Ryafar/ESP32-SoilSensor_KiCad-PCB/docs/hardware/3D/TOP_3D_rev0.1.0.png

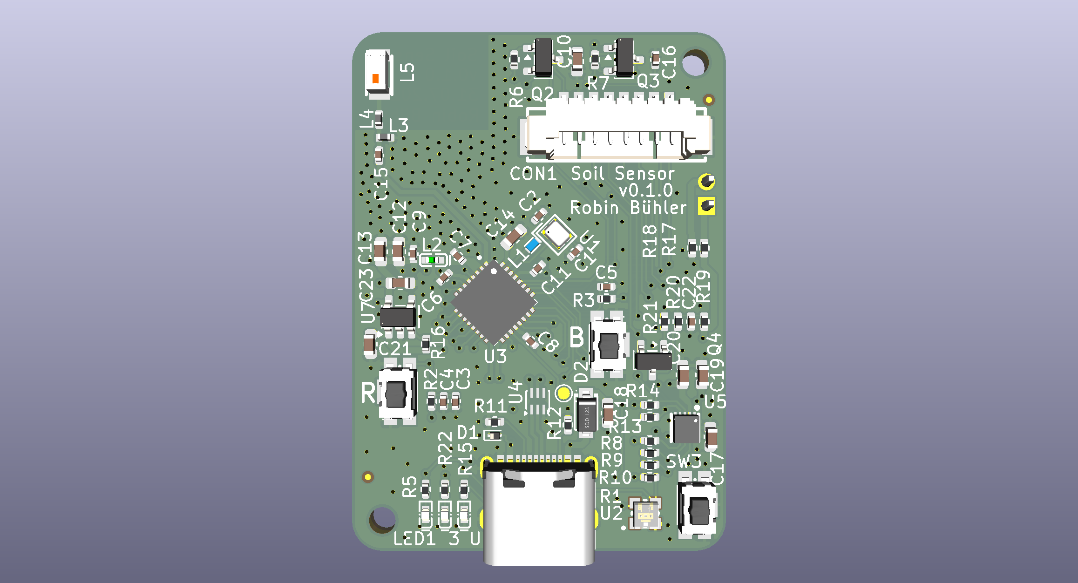
docs/hardware/3D/TOP_3D_rev0.1.0.png
