Ryafar/ESP32-SoilSensor_KiCad-PCB/docs/hardware/3D/soil-sensor_pcb_dimensions_rev0.1.0.pdf

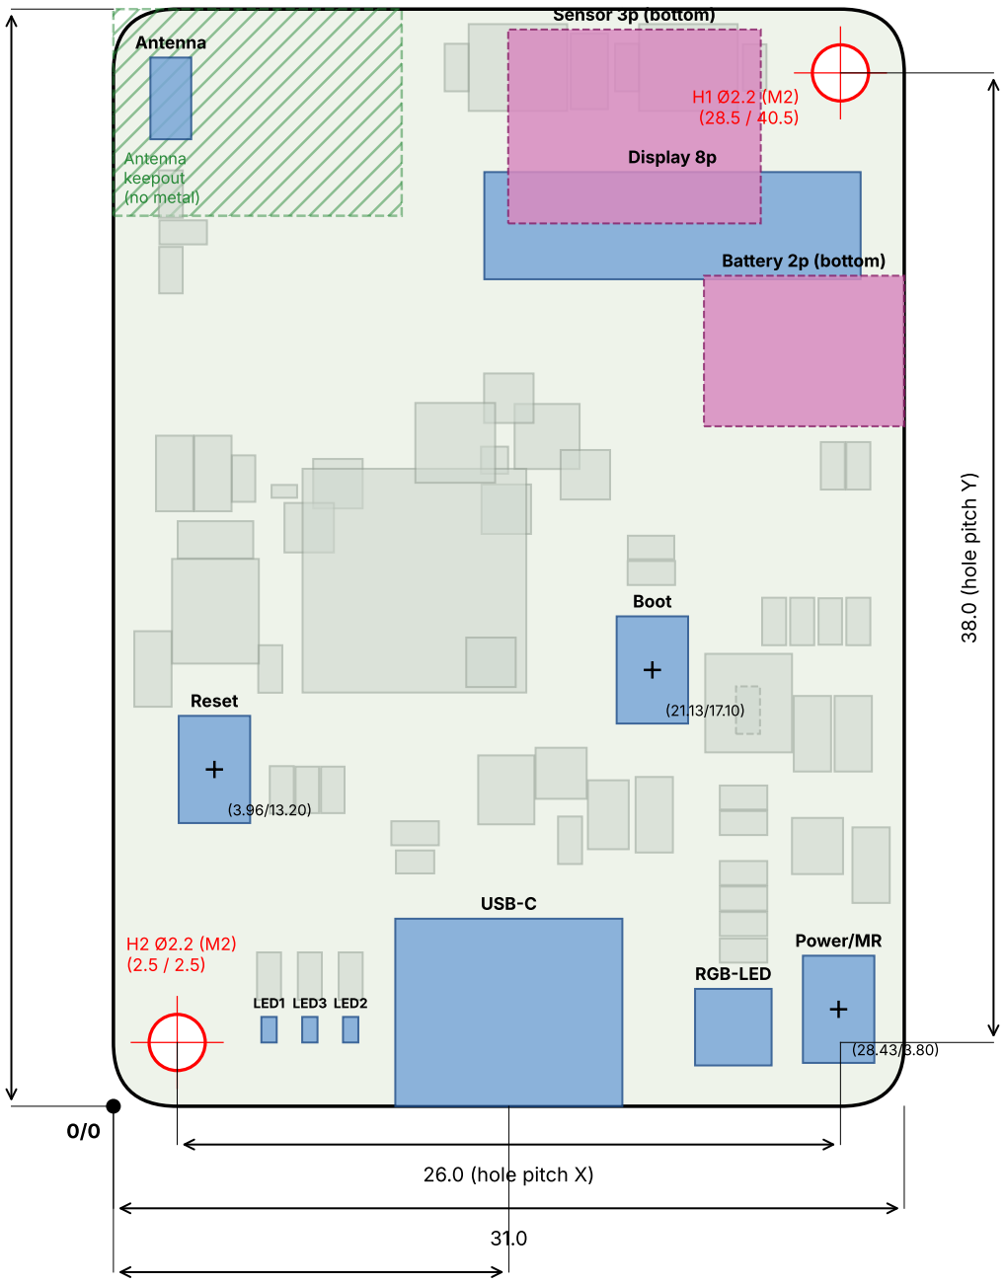
[picture p3: figure]
Antenna keepout (no metal); LED3; USB-C; Power/MR; Boot; Display 8p; Reset; LED1; LED2; Antenna; RGB-LED; Sensor 3p (bottom); Battery 2p (bottom); 26.0 (hole pitch X); 38.0 (hole pitch Y)

43.0

## 15.5 (USB center)

### R2.5 all corners · thickness 1.6 mm · dimensions in mm · top view blue = top side, pink dashed = bottom side

## Soil Sensor v0.1.0 – PCB Dimension Drawing
