Ryafar/ESP32-SoilSensor_KiCad-PCB/docs/hardware/3D/BOT_3D.png

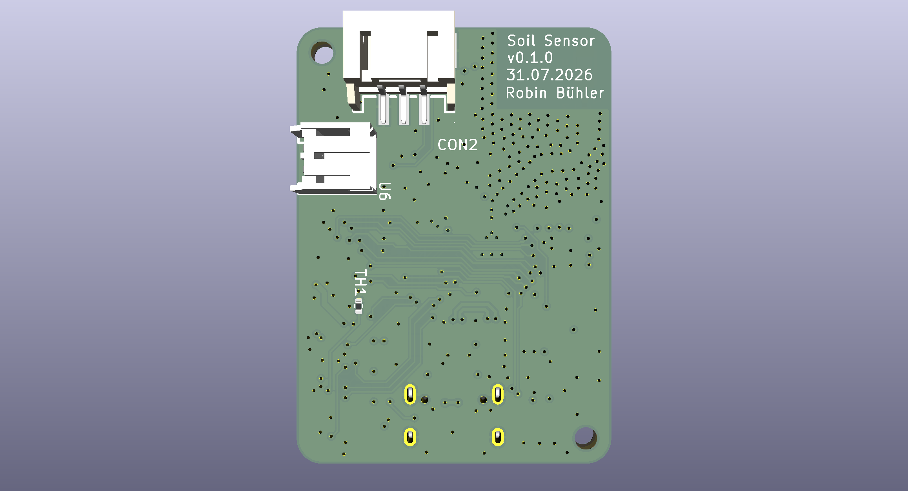
docs/hardware/3D/BOT_3D.png
