Ryafar/ESP32-SoilSensor_KiCad-PCB/docs/hardware/3D/soil-sensor_pcb_outline_rev0.1.0.dxf

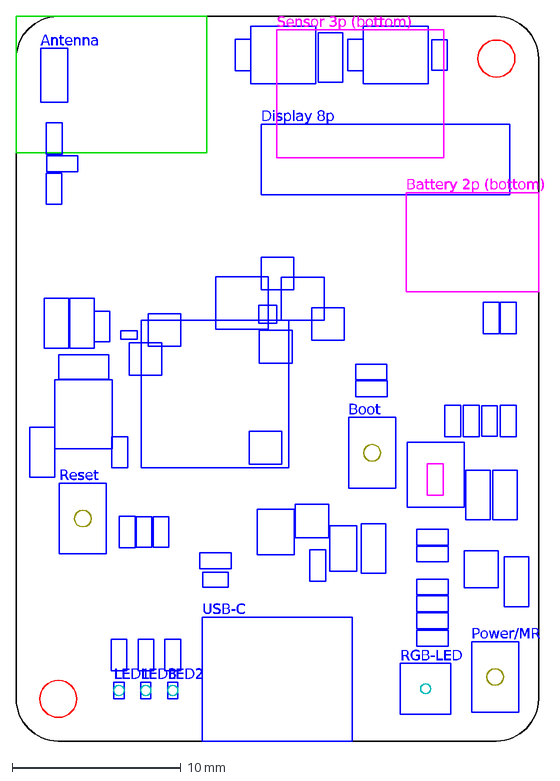
[picture p5: CAD file, 2026-10-10]
docs/hardware/3D/soil-sensor_pcb_outline_rev0.1.0.dxf
LED3
USB-C
Power/MR
Boot
Display 8p
Reset
LED1
LED2
Antenna
RGB-LED
Sensor 3p (bottom)
Battery 2p (bottom)
