Ryafar/ESP32-SoilSensor_KiCad-PCB/docs/hardware/Schematic_v0.1.0.pdf

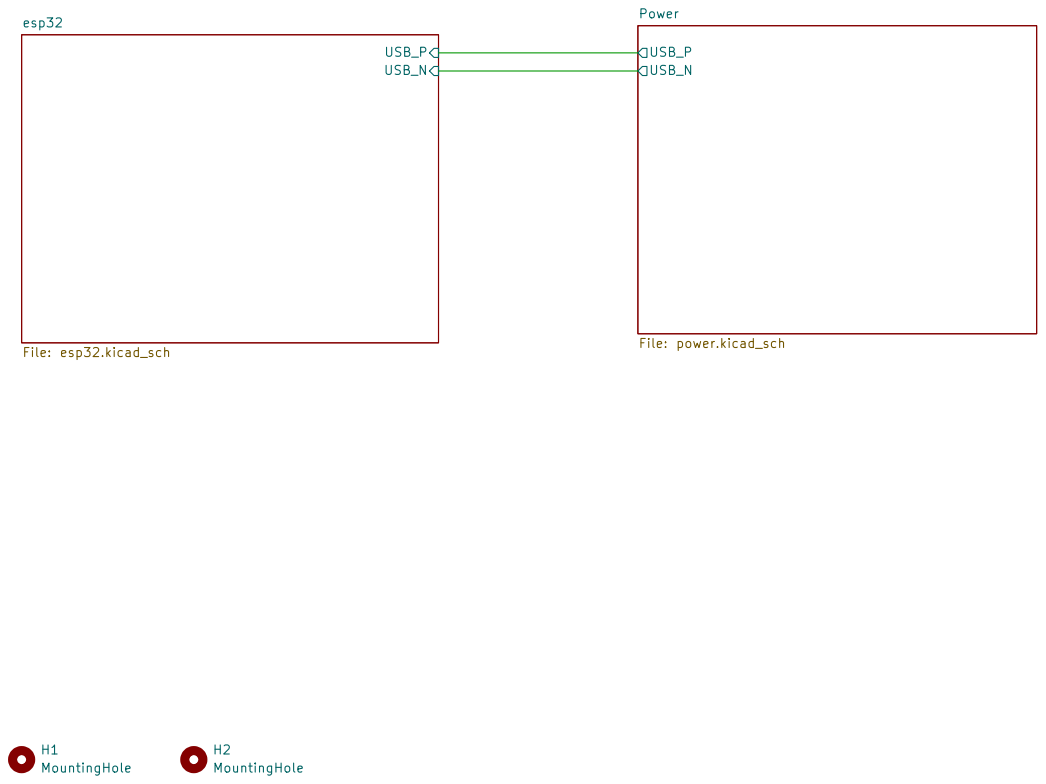
[picture p6: page 1]

Size: A3 | Rev: 0.1.0 | F Date: 2026-06-26
KiCad E.D.A. 10.0.1 | Id: 1/3

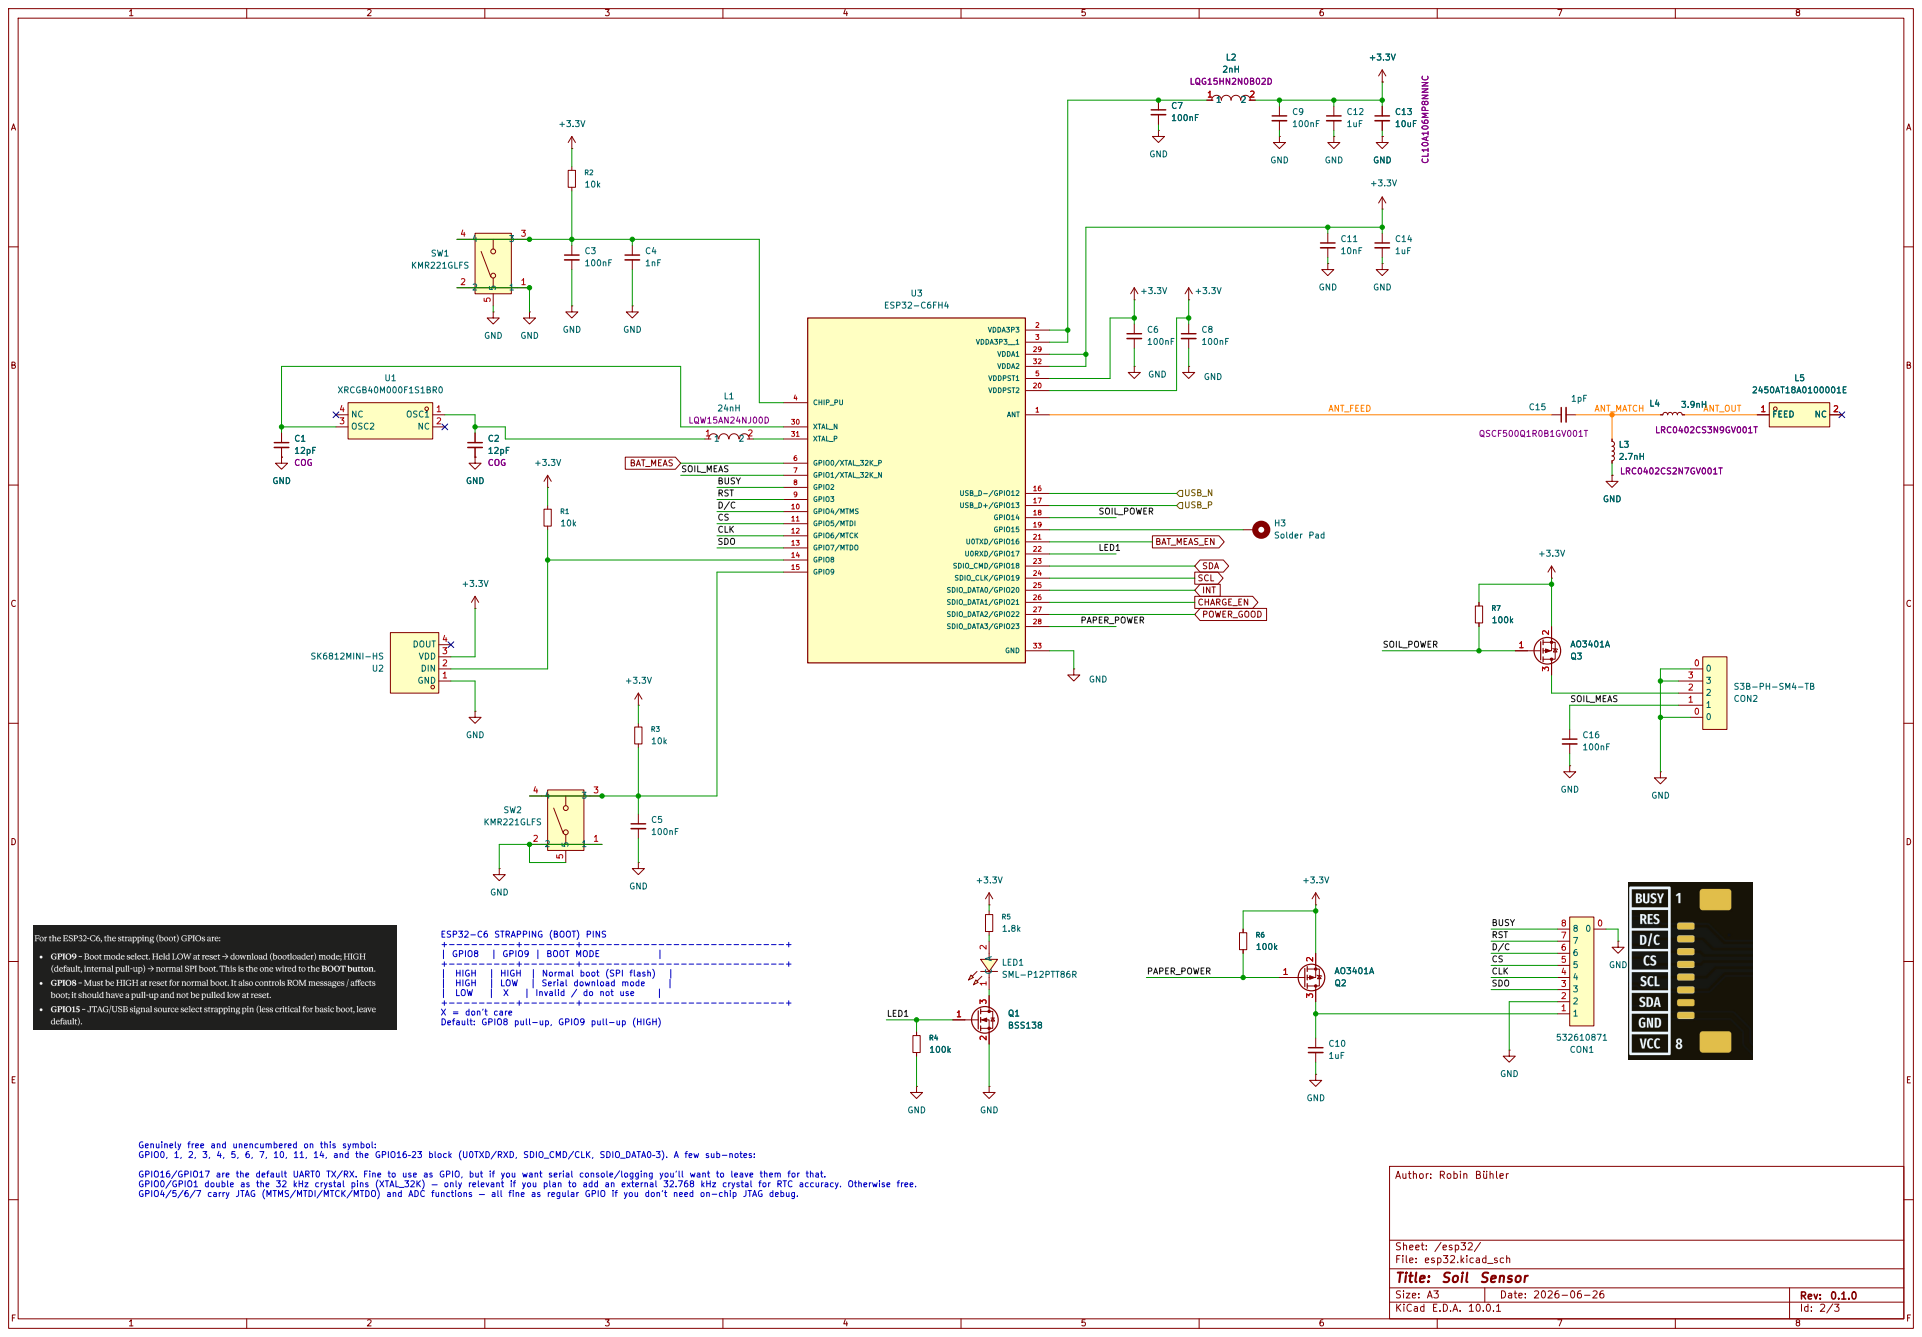
[picture p7: page 2]

LED1 Genuinely free and unencumbered on this symbol:

GPIO0, 1, 2, 3, 4, 5, 6, 7, 10, 11, 14, and the GPIO16–23 block (U0TXD/RXD, SDIO_CMD/CLK, SDIO_DATA0–3). A few sub-notes: GPIO16/GPIO17 are the default UART0 TX/RX. Fine to use as GPIO, but if you want serial console/logging you'll want to leave them for that. GPIO0/GPIO1 double as the 32 kHz crystal pins (XTAL_32K) — only relevant if you plan to add an external 32.768 kHz crystal for RTC accuracy. Otherwise free. GPIO4/5/6/7 carry JTAG (MTMS/MTDI/MTCK/MTDO) and ADC functions — all fine as regular GPIO if you don't need on-chip JTAG debug. ESP32-C6 STRAPPING (BOOT) PINS +---------+-------+---------------------------+

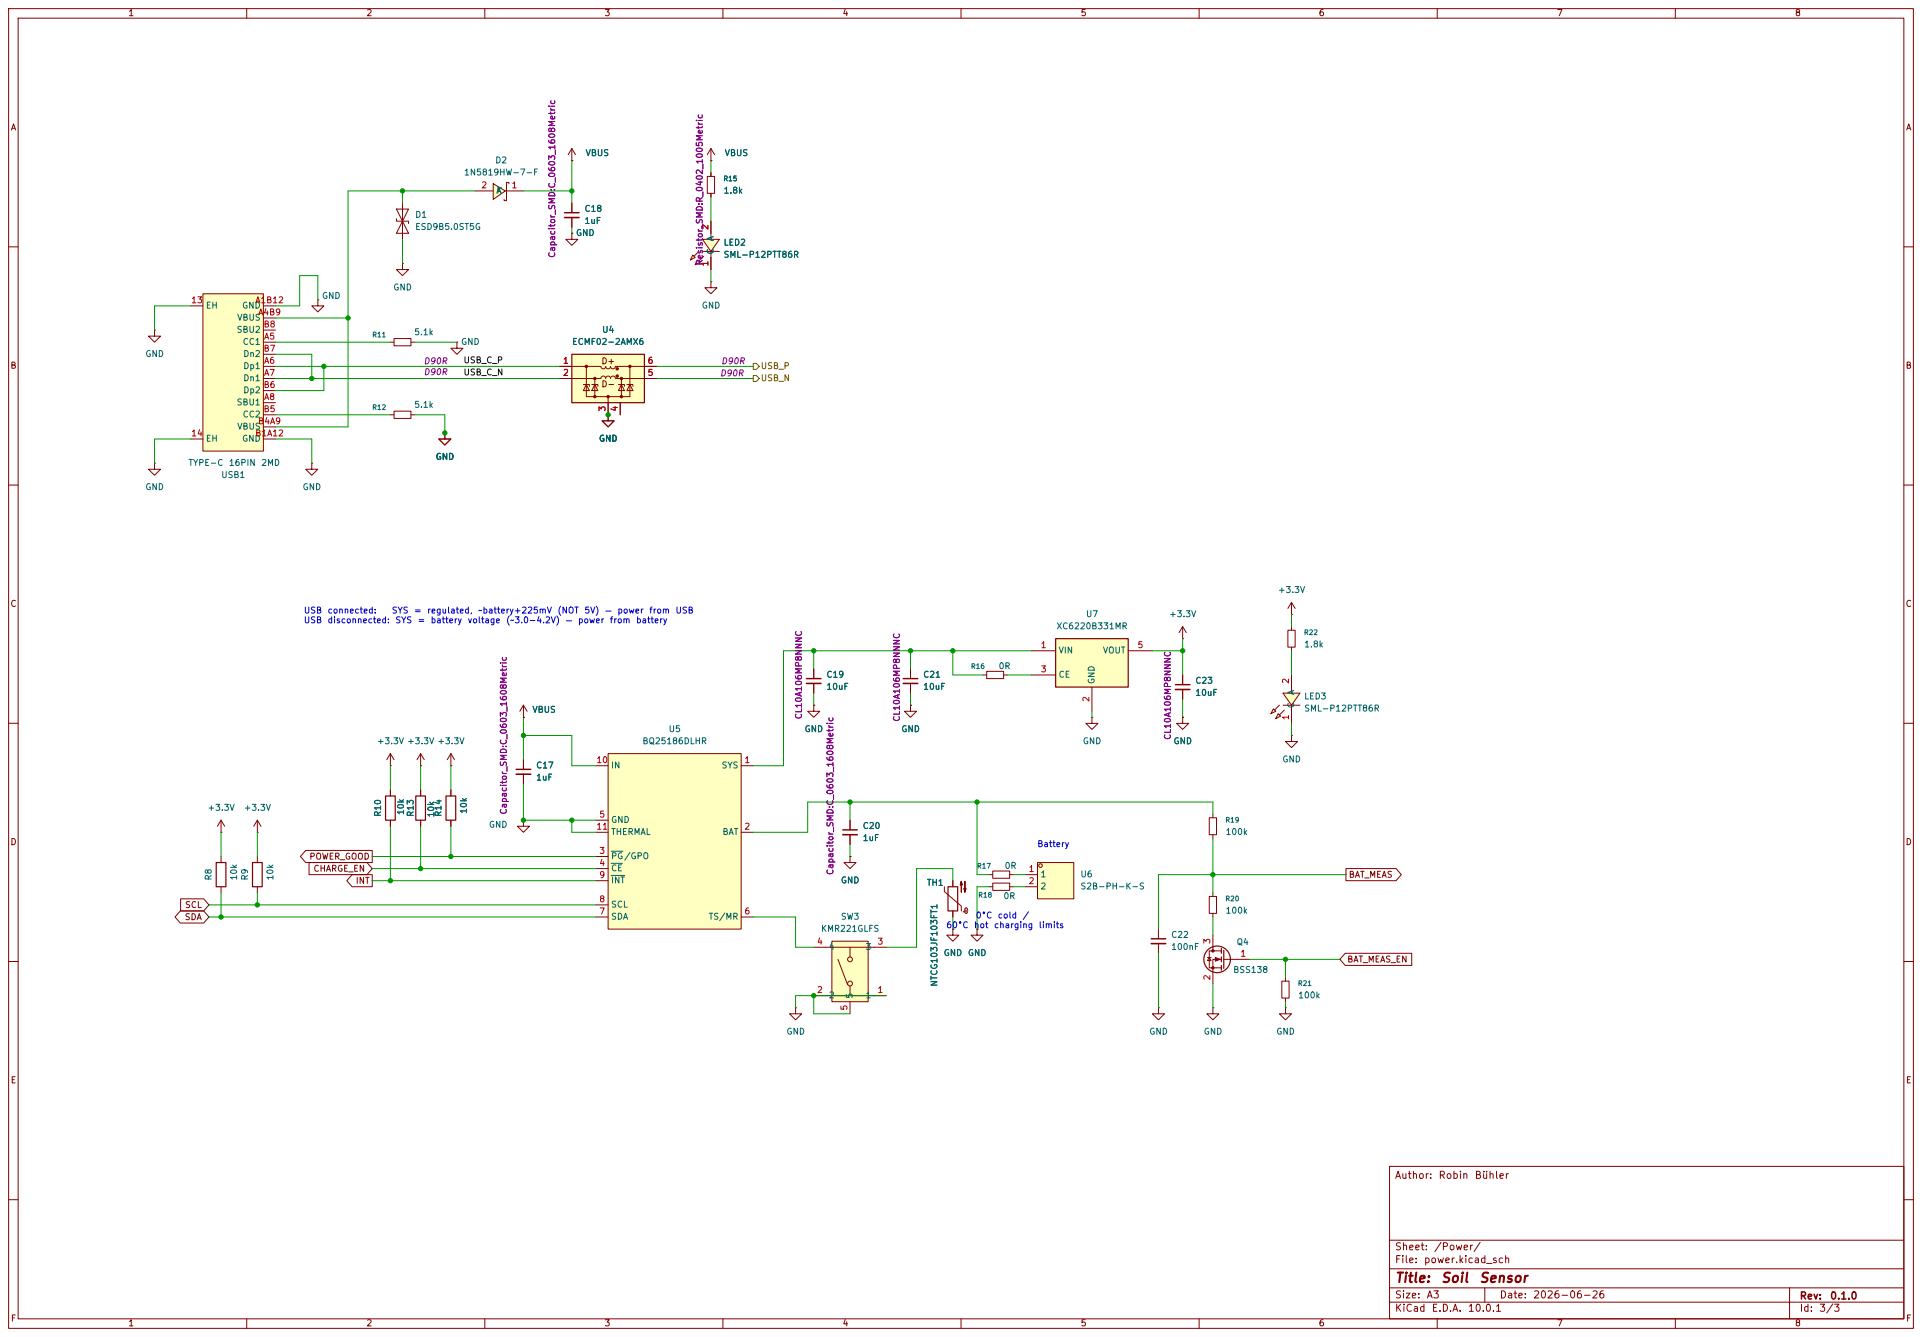
[picture p8: page 3]
