Ryafar/ESP32-SoilSensor_KiCad-PCB/main/config.h

/* Board configuration for the Soil Sensor, KiCad project rev 0.1.0.
 *
 * Single source of truth for pin assignment and system-wide constants.
 * Taken from docs/hardware/hardware-info.md - keep both in sync when the
 * board changes. Drivers under components/ stay board-agnostic and receive
 * these values through their init structs.
 *
 * What is NOT here: the switches that decide how the firmware behaves rather
 * than what the board is. They sit in one block at the top of
 * main/app/app_run.c - deep sleep on or off, ship mode armed, the radio, and
 * the bench overrides that fake a flat cell. This file answers "what is
 * wired where and at which voltage"; that block answers "what does the
 * firmware do with it".
 */
#pragma once

/* --- E-ink display, SPI (CON1) ------------------------------------------ */
#define PIN_EPD_BUSY        2   // input
#define PIN_EPD_RST         3   // output
#define PIN_EPD_DC          4   // output
#define PIN_EPD_CS          5   // output
#define PIN_EPD_CLK         6   // SPI SCLK
#define PIN_EPD_MOSI        7   // SPI MOSI, display is write-only
#define PIN_EPD_POWER      23   // load switch for the display rail (AO3401A)

/* Which of the two panels is fitted is a build-time choice and lives in
 * components/eink/include/eink_panel.h - it decides which controller driver is
 * compiled, so it cannot come from here. */

/* SPI2 is the only general-purpose SPI host on the C6, and the display is the
 * only device on it. Expanded at the point of use, so config.h stays free of
 * ESP-IDF headers. */
#define EPD_SPI_HOST        SPI2_HOST

/* AO3401A is a P-FET high-side switch: the gate goes to GND to conduct.
 * Confirmed against the schematic. */
#define EPD_POWER_ACTIVE_LOW 1

/* --- Soil probe (CON2) --------------------------------------------------- */
#define PIN_SOIL_MEAS       1   // ADC input
#define PIN_SOIL_POWER     14   // load switch, power the probe only while sampling

/* Same AO3401A P-FET arrangement as the display rail. */
#define SOIL_POWER_ACTIVE_LOW 1

/* Time between switching the probe rail on and the first conversion. The
 * hardware document only ever guessed at "tens of ms"; soil_test_task samples a
 * ramp after power-up and logs where the output actually flattens, so this is
 * the number to correct once that ramp has been read off a real probe.
 * Must stay above one FreeRTOS tick (10 ms at CONFIG_FREERTOS_HZ=100) -
 * pdMS_TO_TICKS truncates anything shorter to no delay at all. */
#define SOIL_SETTLE_MS              100
#define SOIL_ADC_SAMPLES            16      // averaged per reading

/* Two-point calibration, docs/product-design.md §7. The probe's output falls as
 * the soil gets wetter, so dry has to be the larger number - soil_init()
 * rejects the other order rather than reporting a percentage derived from a
 * negative span.
 *
 * Chosen rather than measured: 1.0 V counts as fully wet, 2.5 V and above as
 * fully dry. Both ends are clamped, so the probe reading 2736 mV in air simply
 * reads 0 %, and dunking it below 1.0 V reads 100 %. That is deliberate - the
 * scale is a gardening aid, and rounding the ends off costs nothing the number
 * was ever precise enough to say.
 *
 * 1500 mV of span over 100 points means one percent is 15 mV, comfortably
 * above the probe's own noise. Worth revisiting with the probe actually in soil
 * at working depth: potting mix never reaches either end of this scale. */
#define SOIL_CALIBRATION_DRY_MV     2500
#define SOIL_CALIBRATION_WET_MV     1000

/* When the screen stops being black and starts being yellow, then red. These
 * are about the plant, not about the display, which is why they live here and
 * the panel only ever sees "ok / warn / alert".
 *
 * Both inherit the calibration's uncertainty: while the wet point above is a
 * placeholder, so is the meaning of "20 %". Worth re-picking once the probe has
 * been in water - the colour logic itself does not change. */
#define SOIL_WARN_PERCENT           40      // drying out
#define SOIL_ALERT_PERCENT          20      // water it now

/* How far the reading has to move before the screen is worth rewriting. One
 * percent is 15 mV on this scale, which is inside the probe's own noise - so
 * without a step here the displayed value jitters by a point and every jitter
 * would cost a full panel refresh. Two points is still finer than anyone reads
 * off a plant pot. Crossing a colour threshold redraws regardless. */
#define SOIL_DISPLAY_STEP_PERCENT   2

/* --- Battery / charger BQ25186 ------------------------------------------- */
#define PIN_I2C_SDA        18
#define PIN_I2C_SCL        19
#define PIN_CHARGER_INT    20   // input, active low, 10k pull-up on the board
#define PIN_CHARGE_EN      21   // output, 10k pull-up on the board
#define PIN_POWER_GOOD     22   // input, 10k pull-up on the board
#define PIN_BAT_MEAS        0   // ADC input, behind the divider
#define PIN_BAT_MEAS_EN    16   // BSS138, assert only while reading

/* The charger pins carry 10 kOhm pull-ups, so the ESP32's internal ones are
 * redundant on INT, CHARGE_EN and POWER_GOOD. BAT_MEAS_EN has a pull-down
 * instead: the divider stays disconnected while the MCU sleeps or is in reset,
 * and only a driven high connects it. */
#define BAT_MEAS_EN_ACTIVE_HIGH 1

/* CHARGE_EN is the charger's /CE pin: low (or floating) enables charging while
 * VIN is valid, high disables it, and it has no effect at all without VIN.
 *
 * The chip's internal 5 MOhm pulldown means an unconnected pin would enable
 * charging - but this board's 10 kOhm pull-up overrides that by three orders of
 * magnitude, so on this board charging is DISABLED until firmware drives the
 * pin low. That is why nothing charged before this was implemented.
 *
 * Driving it low costs VSYS/10k, about 330 uA, for as long as it is low. That
 * is irrelevant next to a 250 mA charge current and 33x the whole deep-sleep
 * budget, so the pin goes low only while VIN is actually present.
 *
 * A future board revision should drop this pull-up (or make it a pull-down):
 * the chip's own default is the state you want, and then charging would work
 * even with no firmware running at all. */
#define CHARGE_EN_ACTIVE_LOW 1

/* --- RGB status LED ------------------------------------------------------ */
/* Wuerth WL-ICLED 1312020030000, WS2812-compatible single-wire protocol.
 * Strapping pin: must not be held low at reset. */
#define PIN_RGB_DIN         8

/* --- Status LED (LED1) --------------------------------------------------- */
/* SML-P12PTT86R behind a 1.8 kOhm resistor, lit by driving the pin high.
 * Unused by the firmware today, and that is a deliberate default rather than an
 * oversight: it draws about 0.8 mA, which is ~19 mAh per day out of a 500 mAh
 * cell and would flatten it in under four weeks on its own - nearly two orders
 * of magnitude above the ~10 uA deep-sleep target. Whatever this pin ends up
 * doing, it must not be a steady state.
 *
 * GPIO17 is also UART0 RX by default on the C6, which is the second reason the
 * UART console has to stay disabled (the first is GPIO16 = BAT_MEAS_EN): an
 * input pull-up on this net leaks ~70 uA through the LED and may glow faintly.
 *
 * The pin is driven low at boot so "off" is a driven level rather than an
 * assumption about what the ROM left behind. */
#define PIN_STATUS_LED     17
#define STATUS_LED_ACTIVE_HIGH 1

/* --- Buttons ------------------------------------------------------------- */
#define PIN_BOOT_BUTTON     9   // strapping pin, low at reset -> download mode

/* --- I2C ----------------------------------------------------------------- */
#define I2C_CLK_HZ          100000  // 100 kHz while bringing the bus up
#define BQ25186_I2C_ADDR    0x6A

/* --- Charger configuration ----------------------------------------------- */
/* The 10 mA reset default must be overwritten, and the charger watchdog reverts
 * every register after 160 s without an I2C transaction - so this is rewritten
 * on every wake rather than once at first boot (product design §3.3). */
#define BQ25186_REG_ICHG_CTRL       0x04
#define BQ25186_ICHG_500MA          0x4D    // raw register code, bring-up pokes only

/* The cell is the knob; the current follows from it. 0.5C is safe for this
 * 500 mAh pack without leaning on its datasheet allowing 1C, and it stays safe
 * if a larger cell is fitted instead (product design §3.4, which supersedes the
 * 500 mA figure in hardware README §4.2). */
#define BATTERY_CAPACITY_MAH        500
#define BATTERY_CHARGE_RATE_PERCENT 50
#define BATTERY_CHARGE_CURRENT_MA   (BATTERY_CAPACITY_MAH * BATTERY_CHARGE_RATE_PERCENT / 100)

/* --- Battery measurement -------------------------------------------------- */
/* 1:2 divider, 2 x 100 kOhm with 100 nF to GND. Kept as a number rather than a
 * literal *2 in the code: resistor tolerance means the real ratio is not
 * exactly 2, so calibrating against a multimeter changes this one constant.
 * At 4.2 V the ADC sees 2.1 V, which fits ADC_ATTEN_DB_12. */
#define BATTERY_DIVIDER_RATIO       2.0f
/* With BAT_MEAS_EN low the BSS138 opens the divider's low leg, so the ADC node
 * is pulled up to VBAT through the top 100k and sits there. Every reading
 * therefore starts by discharging the 100 nF through 100k||100k: tau = 5 ms,
 * and it takes about 5 tau to land within a millivolt of VBAT/2.
 * Must also stay above one FreeRTOS tick (10 ms at CONFIG_FREERTOS_HZ=100) -
 * pdMS_TO_TICKS truncates, and anything below a tick does not delay at all. */
#define BATTERY_SETTLE_MS           30
#define BATTERY_ADC_SAMPLES         16      // averaged per reading

/* --- Battery thresholds -------------------------------------------------- */
/* Soft threshold, enforced in firmware: below this the board enters ship mode.
 * The charger's own BUVLO sits at 3.0 V and is only a backstop. */
#define BATTERY_SHIP_MODE_MV        3300
/* Leaving the low state happens higher than entering it. A cell at 3.35 V sags
 * below 3.3 V the moment WiFi transmits, and a single threshold would produce a
 * device that shuts down, gets plugged in, boots and shuts down again
 * (product design §3.2). */
#define BATTERY_RECOVER_MV          3500

/* --- Timing -------------------------------------------------------------- */
/* The soil probe's settle time lives with the other soil constants above.
 *
 * Two separate numbers on purpose: the board wakes to measure, and only every
 * n-th measurement pays for the radio. 5 min x 6 = one publish every half hour
 * is the design target (product design §2).
 *
 * The publish divisor is the design value: the samples in between are kept in
 * RTC memory and sent as one bundle, so nothing is lost by talking to the
 * broker less often. Only the interval is turned down for bench work, where
 * five minutes between log lines just means waiting - at 60 s a bundle of six
 * arrives every six minutes instead of every half hour. */
#define MEASUREMENT_INTERVAL_S      60      // design: 5 * 60
#define PUBLISH_EVERY_N_MEASUREMENTS 6
