Ryafar/ESP32-SoilSensor_KiCad-PCB/main/app/app_run.c

/* The application: measure, log, report.
 *
 * The §2 sequence of docs/product-design.md: rails safe, charger configured,
 * battery read, threshold branch, soil sampled, published, drawn, asleep.
 *
 * There is no long-running program. With APP_USE_DEEP_SLEEP the whole thing is
 * app_main -> measure once -> deep sleep, and the next wake is a fresh boot with
 * RAM cleared. What has to survive a cycle lives in RTC memory and is marked
 * RTC_DATA_ATTR: the measurement counter here, the last drawn screen in
 * app_display.c, the discovery flag in app_net.c. Everything else is rebuilt
 * from scratch every five minutes, which is a feature - there is no state to
 * get subtly wrong over a week of uptime.
 *
 * APP_USE_DEEP_SLEEP 0 keeps the same sequence in a task on a vTaskDelay
 * instead. The measurement path is identical; only what happens at the end
 * differs. That is the bench mode, and it exists because a USB serial console
 * does not survive deep sleep (see the comment on the switch).
 *
 * What is not implemented yet, and is not pretended to be: ship mode on a flat
 * cell (see APP_ALLOW_SHIP_MODE), the RTC sample ring buffer and bundled
 * publishing (§6.2 says publishing every cycle is the right first
 * implementation), SNTP and timestamps (§5), reading the calibration from NVS,
 * and the charger's latched FLAG0 events - which now go unseen between wakes.
 */
#include "app_run.h"

#include <inttypes.h>
#include <time.h>

#include "driver/gpio.h"
#include "driver/i2c_master.h"
#include "esp_adc/adc_oneshot.h"
#include "esp_attr.h"
#include "esp_check.h"
#include "esp_log.h"
#include "esp_sleep.h"
#include "freertos/FreeRTOS.h"
#include "freertos/task.h"

#include "app_buffer.h"
#include "app_display.h"
#include "app_net.h"
#include "app_sample.h"
#include "battery.h"
#include "bq25186.h"
#include "config.h"
#include "rgb.h"
#include "soil.h"

static const char *TAG = "app";

/* The panel init sequence, the canvas calls and the MQTT publish all run in
 * this one task. The framebuffer itself is on the heap. */
#define MEASURE_TASK_STACK 8192
#define MEASURE_TASK_PRIO 3

#define I2C_TIMEOUT_MS 100

/* ---------------------------------------------------------------------------
 * Behaviour switches. Everything that decides what this firmware does rather
 * than what the board is; the board itself is main/config.h. Six lines, all
 * together, because hunting for them across a file is how one ends up shipping
 * a build with a test override still in it.
 *
 *   APP_ALLOW_SHIP_MODE  1  disconnect the cell for real at the threshold
 *   APP_ENABLE_NETWORK   1  bring the radio up and publish
 *   APP_ENABLE_DISPLAY   1  draw on the panel
 *   APP_USE_DEEP_SLEEP   1  sleep between measurements instead of looping
 *   APP_FAKE_BATTERY_MV  0  pretend the cell is at this voltage
 *   APP_FAKE_USB_ABSENT  0  pretend VIN is gone
 *
 * The last two are the only ones that must be 0 in anything but a test.
 * --------------------------------------------------------------------------- */

/* Ship mode on a flat cell (product design §3.2): at BATTERY_SHIP_MODE_MV with
 * no USB, the firmware tells the charger over I2C to open the BATFET, and the
 * cell is disconnected from the system before it can be discharged any
 * further. That is the whole reason the firmware watches the voltage at all -
 * the chip's own BUVLO at 3.0 V is a backstop, and 3.0 V under load is already
 * deep discharge for a LiPo.
 *
 * Armed. 0 keeps the branch running and logging without the final write, which
 * is what bench work wants when a threshold or the divider ratio is still being
 * checked.
 *
 * It cannot lock the board out: ship mode is refused while VIN is present, so a
 * board on USB always stays awake and flashable. */
#define APP_ALLOW_SHIP_MODE 1

/* 0 keeps the radio down: measure and log, publish nothing. For looking at
 * readings on a bench with no broker reachable, where the reconnect attempt
 * otherwise prints an error every few seconds and buries the numbers.
 *
 * This is a switch about the device's own behaviour - not a per-sensor switch.
 * Which measurements happen is decided by the sequence in §2, from the cell
 * voltage and USB; isolating a single sensor is what main/bringup/ is for. */
#define APP_ENABLE_NETWORK 1

/* 0 leaves the e-paper panel alone. A refresh blocks the measure task for
 * 2.5 s on the black/white panel and around 21 s on the four-colour one, which
 * is a long time to wait when the thing being debugged is a sensor reading.
 *
 * Which panel is fitted is a separate, build-time choice and lives in
 * components/eink/include/eink_panel.h. */
#define APP_ENABLE_DISPLAY 1

/* 1 = the real thing: measure once, then deep sleep for
 * MEASUREMENT_INTERVAL_S. 0 = the same sequence in a task with a vTaskDelay,
 * which is what a bench session wants.
 *
 * The reason to keep the loop at all: deep sleep powers down the USB-Serial-JTAG
 * peripheral, so the board disappears from USB on every cycle and the serial
 * monitor has to reconnect - with a 60 s interval that makes the log nearly
 * unreadable. When sleeping, watch MQTT rather than the console. */
#define APP_USE_DEEP_SLEEP 1

/* Bench overrides for the battery branches, which are otherwise untestable
 * without draining a cell for days or hanging a supply off the connector.
 *
 * APP_FAKE_BATTERY_MV replaces the measured cell voltage; 0 uses the real one.
 * APP_FAKE_USB_ABSENT makes the decision believe VIN is gone. Both are needed
 * together to reach LOW BATTERY on a bench: with USB actually present the
 * sequence goes to CHARGE WAIT, which is correct and exactly what it should do.
 *
 * They fake the *decision inputs*, not the hardware. Charging keeps following
 * the charger's real VIN bit, so a board on USB still charges while pretending
 * not to be - the log line shows usb=0 next to charging enabled, which looks
 * odd and is honest.
 *
 * Both are logged loudly on every cycle, because a forgotten override publishes
 * a wrong battery voltage to Home Assistant for as long as it stays set. Never
 * combine them with APP_ALLOW_SHIP_MODE unless that is precisely the test. */
#define APP_FAKE_BATTERY_MV 0
#define APP_FAKE_USB_ABSENT 0

/* What the sequence decided this cycle. Logged by name, because "which branch
 * did it take" is the first question about any reading. */
typedef enum {
    CYCLE_MEASURE = 0,  // cell is fine, take a reading
    CYCLE_MEASURE_NO_CELL, // cell unreadable but USB is feeding the board: measure anyway
    CYCLE_CHARGE_WAIT,  // low but on USB: wait, measure nothing
    CYCLE_LOW_BATTERY,  // low and no USB: ship mode
    CYCLE_NO_BATTERY,   // cell unreadable and no USB either: measure nothing
} cycle_decision_t;

static i2c_master_bus_handle_t s_i2c_bus;
static adc_oneshot_unit_handle_t s_adc;

/* Survives deep sleep: it is the sequence number in the MQTT payload, and a
 * counter that restarted at 1 every cycle would make a gap in the data
 * indistinguishable from a reboot. */
static RTC_DATA_ATTR uint32_t s_measurements;

static const char *decision_name(cycle_decision_t decision)
{
    switch (decision) {
    case CYCLE_MEASURE:
        return "MEASURE";
    case CYCLE_MEASURE_NO_CELL:
        return "MEASURE (no cell, on USB)";
    case CYCLE_CHARGE_WAIT:
        return "CHARGE WAIT";
    case CYCLE_LOW_BATTERY:
        return "LOW BATTERY";
    case CYCLE_NO_BATTERY:
        return "NO BATTERY READING";
    }
    return "?";
}

static esp_err_t init_i2c(void)
{
    const i2c_master_bus_config_t bus_config = {
        .i2c_port = -1, // let the driver pick a free port
        .sda_io_num = PIN_I2C_SDA,
        .scl_io_num = PIN_I2C_SCL,
        .clk_source = I2C_CLK_SRC_DEFAULT,
        .glitch_ignore_cnt = 7,
        .flags.enable_internal_pullup = true,
    };
    return i2c_new_master_bus(&bus_config, &s_i2c_bus);
}

/* ADC1 is shared: the battery divider is on GPIO0, the soil probe on GPIO1.
 * The unit can only be created once, so this file owns it and lends the
 * handle to both drivers. */
static esp_err_t init_adc(void)
{
    const adc_oneshot_unit_init_cfg_t init_config = {
        .unit_id = ADC_UNIT_1,
    };
    return adc_oneshot_new_unit(&init_config, &s_adc);
}

/* LED1 is not used by anything yet, so the only thing worth doing with it is
 * making sure it is off - as a driven level, not as a hope about what the ROM
 * left on the pad. GPIO17 is UART0 RX by default and can come up with a
 * pull-up, which would leak through the LED for the rest of the cell's life.
 * See config.h for the arithmetic. */
static esp_err_t init_status_led_off(void)
{
    const gpio_config_t led_config = {
        .pin_bit_mask = 1ULL << PIN_STATUS_LED,
        .mode = GPIO_MODE_OUTPUT,
        .pull_up_en = GPIO_PULLUP_DISABLE,
        .pull_down_en = GPIO_PULLDOWN_DISABLE,
        .intr_type = GPIO_INTR_DISABLE,
    };
    ESP_RETURN_ON_ERROR(gpio_config(&led_config), TAG, "status led config failed");
    return gpio_set_level(PIN_STATUS_LED, STATUS_LED_ACTIVE_HIGH ? 0 : 1);
}

static esp_err_t init_drivers(void)
{
    ESP_RETURN_ON_ERROR(init_status_led_off(), TAG, "status led off failed");

    const rgb_config_t rgb_cfg = {
        .gpio_num = PIN_RGB_DIN,
        .brightness = 16,
    };
    ESP_RETURN_ON_ERROR(rgb_init(&rgb_cfg), TAG, "rgb init failed");
    rgb_set_status(RGB_STATUS_BOOT);

    ESP_RETURN_ON_ERROR(init_i2c(), TAG, "i2c bus failed");

    const bq25186_config_t charger_cfg = {
        .bus = s_i2c_bus,
        .device_address = BQ25186_I2C_ADDR,
        .scl_speed_hz = I2C_CLK_HZ,
        .timeout_ms = I2C_TIMEOUT_MS,
        /* The board's pull-up holds /CE high, which disables charging, so this
         * pin is not optional here - without it the cell never charges. */
        .ce_gpio = PIN_CHARGE_EN,
        .drive_ce_pin = true,
    };
    ESP_RETURN_ON_ERROR(bq25186_init(&charger_cfg), TAG, "charger init failed");
    ESP_RETURN_ON_ERROR(bq25186_probe(), TAG,
                        "the charger does not answer on the bus - nothing below "
                        "this can be trusted");

    ESP_RETURN_ON_ERROR(init_adc(), TAG, "adc unit failed");

    const battery_config_t battery_cfg = {
        .adc = s_adc,
        .meas_gpio = PIN_BAT_MEAS,
        .enable_gpio = PIN_BAT_MEAS_EN,
        .int_gpio = PIN_CHARGER_INT,
        .power_good_gpio = PIN_POWER_GOOD,
        .enable_active_high = BAT_MEAS_EN_ACTIVE_HIGH,
        .divider_ratio = BATTERY_DIVIDER_RATIO,
        .settle_ms = BATTERY_SETTLE_MS,
        .samples = BATTERY_ADC_SAMPLES,
    };
    ESP_RETURN_ON_ERROR(battery_init(&battery_cfg), TAG, "battery init failed");

    const soil_config_t soil_cfg = {
        .adc = s_adc,
        .meas_gpio = PIN_SOIL_MEAS,
        .power_gpio = PIN_SOIL_POWER,
        .power_active_low = SOIL_POWER_ACTIVE_LOW,
        .settle_ms = SOIL_SETTLE_MS,
        .samples = SOIL_ADC_SAMPLES,
        .dry_mv = SOIL_CALIBRATION_DRY_MV,
        .wet_mv = SOIL_CALIBRATION_WET_MV,
    };
    ESP_RETURN_ON_ERROR(soil_init(&soil_cfg), TAG, "soil init failed");

    return ESP_OK;
}

/* The charger's watchdog reverts every register to its defaults after 160 s
 * without an I2C transaction, so the charge current is rewritten every cycle
 * rather than once at boot (product design §3.3). Configuration here is
 * stateless by design, not by oversight. */
static void configure_charger(void)
{
    const esp_err_t err = bq25186_set_charge_current(BATTERY_CHARGE_CURRENT_MA);
    if (err != ESP_OK) {
        ESP_LOGW(TAG, "could not set the charge current: %s", esp_err_to_name(err));
    }
}

/* The /CE level currently driven, or -1 before anything has been driven this
 * boot. Kept so the log gets one line when charging starts or stops, instead of
 * one every cycle saying the same thing. */
static int s_charging_allowed = -1;

/* Returns true when the level actually changed. */
static bool set_charging_allowed(bool allowed)
{
    if (s_charging_allowed == (int)allowed) {
        return false;
    }

    const esp_err_t err = bq25186_set_ce_pin(allowed);
    if (err != ESP_OK) {
        ESP_LOGW(TAG, "could not drive /CE: %s", esp_err_to_name(err));
        return false;
    }

    s_charging_allowed = allowed;
    ESP_LOGI(TAG, "VIN %s -> charging %s (/CE driven %s)",
             allowed ? "present" : "gone", allowed ? "enabled" : "disabled",
             allowed ? "low" : "high");
    return true;
}

/* Wrapper so the switch appears once instead of at every call site. */
static void update_display(const app_sample_t *sample, bool battery_low)
{
#if APP_ENABLE_DISPLAY
    app_display_update(sample, battery_low);
#else
    (void)sample;
    (void)battery_low;
#endif
}

/* Which cycles talk to the world. Measuring is cheap and happens every wake;
 * the radio and the panel are the expensive pair and they share this cadence.
 *
 * The first measurement after a cold boot always reports, whatever the divisor
 * says. Otherwise a freshly flashed or freshly reset board is silent for
 * PUBLISH_EVERY_N_MEASUREMENTS cycles - half an hour at the design interval -
 * and Home Assistant does not know it exists, because the discovery
 * configuration rides along with the first publish. One extra radio cycle per
 * cold boot is not a power problem; a device that looks dead for thirty minutes
 * after every reset is a usability one.
 *
 * The counter lives in RTC memory, so "sequence 1" means exactly "RTC memory
 * was just zeroed", which is the same thing as a cold boot. */
static bool is_reporting_cycle(uint32_t sequence)
{
    return sequence == 1 || sequence % PUBLISH_EVERY_N_MEASUREMENTS == 0;
}

static cycle_decision_t decide(const battery_reading_t *battery, bool battery_valid,
                               bool usb_present)
{
    if (!battery_valid) {
        /* No cell fitted, or the divider did not switch in. On USB that is the
         * normal bench case - the board is fed from VIN, so the soil rail and
         * the radio are not drawing from a cell whose voltage is unknown, and
         * skipping the measurement would mean a board on a desk that never
         * measures anything.
         *
         * On battery alone it is the opposite: the one thing the thresholds
         * exist to prevent is loading a cell that might be flat. */
        return usb_present ? CYCLE_MEASURE_NO_CELL : CYCLE_NO_BATTERY;
    }
    if (battery->millivolts >= BATTERY_RECOVER_MV) {
        return CYCLE_MEASURE;
    }
    if (battery->millivolts < BATTERY_SHIP_MODE_MV) {
        /* Never ship mode while USB is present: it opens the BATFET and would
         * strand a device that is already being rescued (§3.2). */
        return battery->usb_present ? CYCLE_CHARGE_WAIT : CYCLE_LOW_BATTERY;
    }
    /* Between the two thresholds: coming up from empty means waiting, and a
     * cell on its way down keeps measuring until it crosses the lower one. */
    return battery->usb_present ? CYCLE_CHARGE_WAIT : CYCLE_MEASURE;
}

static void measure_once(void)
{
    app_sample_t sample = {
        .sequence = ++s_measurements,
        /* The RTC clock, which keeps running through deep sleep. Without SNTP
         * its epoch is the last cold boot, which is enough: what gets published
         * is the age of the sample, not a wall-clock time (§5). */
        .taken_at_s = (uint32_t)time(NULL),
        .soil_mv = -1,
        .soil_percent = -1,
        .battery_mv = -1,
    };

    rgb_set_status(RGB_STATUS_MEASURING);
    configure_charger();

    bq25186_charge_state_t charge_state = BQ25186_CHARGE_IDLE;
    bool charger_vin_good = false;
    esp_err_t charge_err = bq25186_read_charge_state(&charge_state, &charger_vin_good);
    if (charge_err != ESP_OK) {
        ESP_LOGW(TAG, "could not read the charger state: %s", esp_err_to_name(charge_err));
    }

    /* Charging is allowed exactly while VIN is there, and the decision comes
     * from the charger's own VIN_PGOOD bit rather than from the board's PGOOD
     * pin - the chip is the thing whose opinion about its input matters.
     *
     * Both directions are load-bearing. Low is what makes the cell charge at
     * all on this board, because the 10 kOhm pull-up would otherwise hold /CE
     * high. High is what keeps that pull-up from burning ~330 uA out of the
     * cell once USB is gone, which is 33x the entire sleep budget. /CE has no
     * effect without VIN, so this is purely about that current. */
    if (charge_err == ESP_OK && set_charging_allowed(charger_vin_good)) {
        /* Re-read after a change: CHG_STAT sampled before the pin moved
         * describes the previous state, and reporting "not charging" on the
         * cycle where charging just started is the kind of off-by-one-cycle
         * that gets debugged twice. */
        charge_err = bq25186_read_charge_state(&charge_state, &charger_vin_good);
    }
    sample.charging = bq25186_charge_state_is_charging(charge_state);

    /* Battery first: every other branch depends on the answer, and a
     * measurement taken on a collapsing rail is worse than no measurement
     * (product design §2). */
    battery_reading_t battery = {0};
    const esp_err_t battery_err = battery_read(&battery);
    bool battery_valid = battery_err == ESP_OK;
    if (battery_valid) {
        sample.battery_mv = battery.millivolts;
    } else {
        ESP_LOGW(TAG, "battery reading failed: %s", esp_err_to_name(battery_err));
    }
    sample.usb_present = battery_valid ? battery.usb_present : charger_vin_good;


    /* The charger's own VIN bit and the board's PGOOD pin should agree. When
     * they do not, one of them is not measuring what it is thought to measure -
     * worth a line rather than a silent preference for either. */
    if (battery_valid && charge_err == ESP_OK && battery.usb_present != charger_vin_good) {
        ESP_LOGW(TAG, "PGOOD pin says USB %s but the charger says %s",
                 battery.usb_present ? "present" : "absent",
                 charger_vin_good ? "present" : "absent");
    }

#if APP_FAKE_BATTERY_MV
    ESP_LOGW(TAG, "APP_FAKE_BATTERY_MV is set: reporting %d mV instead of the "
                  "measured %d mV", APP_FAKE_BATTERY_MV, sample.battery_mv);
    battery.millivolts = APP_FAKE_BATTERY_MV;
    sample.battery_mv = APP_FAKE_BATTERY_MV;
    battery_valid = true;
#endif
#if APP_FAKE_USB_ABSENT
    ESP_LOGW(TAG, "APP_FAKE_USB_ABSENT is set: the decision below believes VIN "
                  "is gone (it is %s)", sample.usb_present ? "present" : "absent");
    battery.usb_present = false;
    sample.usb_present = false;
#endif

    const cycle_decision_t decision = decide(&battery, battery_valid, sample.usb_present);

    if (decision == CYCLE_MEASURE || decision == CYCLE_MEASURE_NO_CELL) {
        soil_reading_t soil = {0};
        const esp_err_t soil_err = soil_read(&soil);
        if (soil_err == ESP_OK) {
            sample.soil_mv = soil.millivolts;
            sample.soil_percent = soil.percent;
        } else {
            ESP_LOGW(TAG, "soil reading failed: %s", esp_err_to_name(soil_err));
        }
    }

    /* One line with everything, so scrolling the log is enough to follow what
     * the device did and why. */
    ESP_LOGI(TAG, "#%" PRIu32 " %s  soil=%d mV (%d %%)  vbat=%d mV  usb=%d  charger=%s",
             sample.sequence, decision_name(decision), sample.soil_mv,
             sample.soil_percent, sample.battery_mv, sample.usb_present,
             bq25186_charge_state_name(charge_state));

    if (decision == CYCLE_LOW_BATTERY) {
        rgb_set_status(RGB_STATUS_BATTERY_LOW);

        /* The screen goes up before ship mode, not after: ship mode opens the
         * BATFET and there is no "after" (product design §2). Whatever is on
         * the glass when the rail dies is what someone finds days later, so it
         * has to be the low-battery frame.
         *
         * It is also the most expensive thing this branch does - 21 s with the
         * panel rail up, on a cell that is already at the threshold. Worth it
         * once: app_display only redraws when the picture changes, so the
         * second and later low-battery cycles skip it and go straight to the
         * I2C write. */
        update_display(&sample, true);
#if APP_ALLOW_SHIP_MODE
        ESP_LOGW(TAG, "cell at %d mV with no USB - disconnecting the battery",
                 sample.battery_mv);

        /* Nothing after this line executes: the BATFET opens while the write is
         * still being acknowledged, and the system rail goes with it. */
        bq25186_enter_ship_mode();
#else
        ESP_LOGW(TAG, "cell at %d mV with no USB - the armed firmware would "
                      "disconnect the battery here; APP_ALLOW_SHIP_MODE is 0",
                 sample.battery_mv);
#endif
        return;
    }

    const bool reporting_cycle = is_reporting_cycle(sample.sequence);

    /* Buffered first, published second. The buffer is what makes a cycle with
     * no network cost nothing: the sample is in RTC memory either way, and the
     * next cycle that reaches the broker sends it along with the rest. */
    app_buffer_add(&sample);

#if APP_ENABLE_NETWORK
    if (reporting_cycle) {
        /* Copied out into one flat array rather than published straight from
         * the ring, which saves the publisher from knowing that the buffer
         * wraps. Static for the same reason app_net's payload is: with deep
         * sleep this runs on the main task, whose stack has no room for a
         * kilobyte of samples on top of the publish. */
        static app_sample_t bundle[APP_BUFFER_SLOTS];
        size_t count = 0;
        for (const app_sample_t *sample_at = app_buffer_at(0); sample_at != NULL;
             sample_at = app_buffer_at(count)) {
            bundle[count++] = *sample_at;
        }

        const esp_err_t err = app_net_publish(bundle, count);
        if (err == ESP_OK) {
            /* Only now. Anything else - no association, refused connection,
             * missing PUBACK - leaves the samples where they are, and the next
             * cycle sends more rather than less. */
            app_buffer_clear();
        } else if (err != ESP_ERR_INVALID_STATE) {
            /* ESP_ERR_INVALID_STATE is "not connected", which app_net has
             * already logged - no second line for the same fact. */
            ESP_LOGW(TAG, "publish failed: %s - %u samples stay buffered",
                     esp_err_to_name(err), (unsigned)count);
        }
    }
#endif

    /* Last, and after the publish, because it is the only step that can be
     * skipped without losing data - and because it is by far the slowest
     * (product design §2).
     *
     * Only on a reporting cycle, and app_display still redraws only when the
     * picture would differ. Both gates are needed: the change test alone lets
     * ADC noise of one percentage point trigger a refresh on nearly every wake,
     * and at roughly 0.1 mAh per 21-second refresh, 288 wakes a day would come
     * to something like 29 mAh - more than everything else on this board put
     * together. The display is not the reason the cell goes flat. */
    if (reporting_cycle) {
        update_display(&sample, false);
    }

    /* The LED says what the board is doing between measurements. It costs real
     * current and comes off the budget once deep sleep lands - for bench work
     * it is the fastest way to see the state from across the room. */
    rgb_set_status(sample.charging ? RGB_STATUS_CHARGING : RGB_STATUS_OFF);
}

static void start_network(void)
{
#if APP_ENABLE_NETWORK
    /* Before the measurement, so this cycle's sample can be published.
     * Failing to associate is not fatal: the reading still reaches the log and
     * the screen. */
    const esp_err_t err = app_net_start();
    if (err != ESP_OK) {
        ESP_LOGW(TAG, "network not up (%s) - measuring anyway", esp_err_to_name(err));
    }
#else
    ESP_LOGW(TAG, "APP_ENABLE_NETWORK is 0 - radio stays down, nothing is "
                  "published, readings go to the log only");
#endif
}

#if APP_USE_DEEP_SLEEP
/* Everything that has to be true before the chip stops running. Never returns.
 *
 * The order matters: the LED goes dark before its peripheral is released, the
 * /CE level is locked before the pads are allowed to freeze, and the timer is
 * armed last so nothing can wake the chip while the rails are still being put
 * away. */
static void enter_deep_sleep(void)
{
    /* The WL-ICLED holds its last colour as long as the 3.3 V rail is up, and
     * that rail stays up through deep sleep - so a lit LED would burn
     * milliamps for the whole interval. Dark first, then the RMT channel goes
     * back. */
    rgb_off();
    rgb_deinit();

    /* The panel rail is already down: app_display powers it off after every
     * refresh, and the image stays on the glass by itself.
     *
     * The two P-FET rails need nothing here - each gate carries a 100 kOhm
     * resistor to its source, so both switches are off the moment the pads go
     * high-impedance (hardware README §7). /CE is the exception: its pull-up
     * would disable charging, which is why it is the one pin held. */
    const bool keep_charging = s_charging_allowed == 1;
    if (keep_charging) {
        /* On the C6 a single-IO hold survives deep sleep by itself
         * (SOC_GPIO_SUPPORT_HOLD_SINGLE_IO_IN_DSLP), so there is no global
         * arming call to make - gpio_deep_sleep_hold_en() does not even exist
         * on this target. The release is the driver's job, in bq25186_init(),
         * because that is where the pin gets reconfigured after the wake. */
        const esp_err_t err = bq25186_ce_pin_hold(true);
        if (err != ESP_OK) {
            ESP_LOGW(TAG, "could not hold /CE: %s - charging pauses while asleep",
                     esp_err_to_name(err));
        }
    }

    ESP_ERROR_CHECK(esp_sleep_enable_timer_wakeup((uint64_t)MEASUREMENT_INTERVAL_S *
                                                  1000000ULL));
    ESP_LOGI(TAG, "sleeping %d s (charging %s)", MEASUREMENT_INTERVAL_S,
             keep_charging ? "stays enabled" : "off, no VIN");
    esp_deep_sleep_start();
}
#else
static void measure_task(void *arg)
{
    while (1) {
        measure_once();
        vTaskDelay(pdMS_TO_TICKS(MEASUREMENT_INTERVAL_S * 1000));
    }
}
#endif

/* Cold boot or a wake from the timer, for the log - and because the two are not
 * interchangeable: a cold boot means RTC memory was just zeroed, so the screen
 * gets a full refresh and the discovery configuration goes out again. Those
 * decisions read the RTC variables rather than this cause, which is the same
 * information from the side that actually matters.
 *
 * The bitmap API, not esp_sleep_get_wakeup_cause(): that one is deprecated in
 * IDF 6.0 because it can only report one source when several fire together. */
static void log_boot_reason(void)
{
    const uint32_t causes = esp_sleep_get_wakeup_causes();

    if (causes == 0) {
        ESP_LOGI(TAG, "cold boot - RTC memory is empty, this is measurement #1");
    } else if (causes & BIT(ESP_SLEEP_WAKEUP_TIMER)) {
        ESP_LOGI(TAG, "woke from deep sleep, measurement #%" PRIu32 " coming up",
                 s_measurements + 1);
    } else {
        ESP_LOGI(TAG, "woke from deep sleep for another reason (causes 0x%" PRIx32 ")",
                 causes);
    }
}

void app_run(void)
{
    ESP_LOGI(TAG, "soil sensor firmware, application build");
    log_boot_reason();
    ESP_LOGI(TAG, "measuring every %d s, publishing every %d measurements, "
                  "charge current %d mA",
             MEASUREMENT_INTERVAL_S, PUBLISH_EVERY_N_MEASUREMENTS,
             BATTERY_CHARGE_CURRENT_MA);

    /* A pad held through the last sleep is frozen until something releases it,
     * and a frozen pad ignores gpio_config(). Each driver releases its own pin
     * in its init - see bq25186_init() - so there is nothing global to undo
     * here on this target. */

    const esp_err_t err = init_drivers();
    if (err != ESP_OK) {
        /* Deliberately not ESP_ERROR_CHECK: that aborts, abort means reboot,
         * and a reboot loop on a battery is a flat cell in a few days with
         * nobody watching (firmware-architecture.md §5). Fault colour, and the
         * log says what failed. */
        ESP_LOGE(TAG, "driver bring-up failed: %s - not measuring",
                 esp_err_to_name(err));
        rgb_set_status(RGB_STATUS_FAULT);
#if APP_USE_DEEP_SLEEP
        /* Sleep anyway. Sitting here awake with a fault would drain the cell
         * faster than trying again in five minutes, and the next cycle is a
         * fresh boot - which is the cheapest recovery attempt available. */
        enter_deep_sleep();
#endif
        return;
    }

#if APP_USE_DEEP_SLEEP
    /* Same predicate as measure_once() uses, one cycle ahead of the counter:
     * the radio has to be up before the sample exists. */
    const bool publish_cycle = is_reporting_cycle(s_measurements + 1);
    if (publish_cycle) {
        start_network();
    }

    measure_once();

#if APP_ENABLE_NETWORK
    if (publish_cycle) {
        app_net_stop();
    }
#endif

    enter_deep_sleep();
#else
    start_network();
    xTaskCreate(measure_task, "measure", MEASURE_TASK_STACK, NULL, MEASURE_TASK_PRIO,
                NULL);

    /* Returns; FreeRTOS deletes the main task and the measure task keeps
     * running. */
#endif
}
