Ryafar/ESP32-SoilSensor_KiCad-PCB/(commit log)

2026-09-06 battery meas test
2026-09-06 soil sensor test, gpio15 was wrong
2026-09-20 tested ship mode, disconnect battery
2026-10-10 docs: fix hardware doc links, add PCB dimensions for rev 0.1.0
    The hardware document was named hardware_README.md while every link
    pointed at hardware/README.md. Rename it to hardware-info.md and update
    all references. Add pcb-dimensions.md with the dimension drawing and DXF
    outline for enclosure design, and put the board revision into the file
    names of the drawings and 3D renders.
